makerspacewi/Lasercutter/doc/Schaltpläne_gr_LasercutterV8.pdf

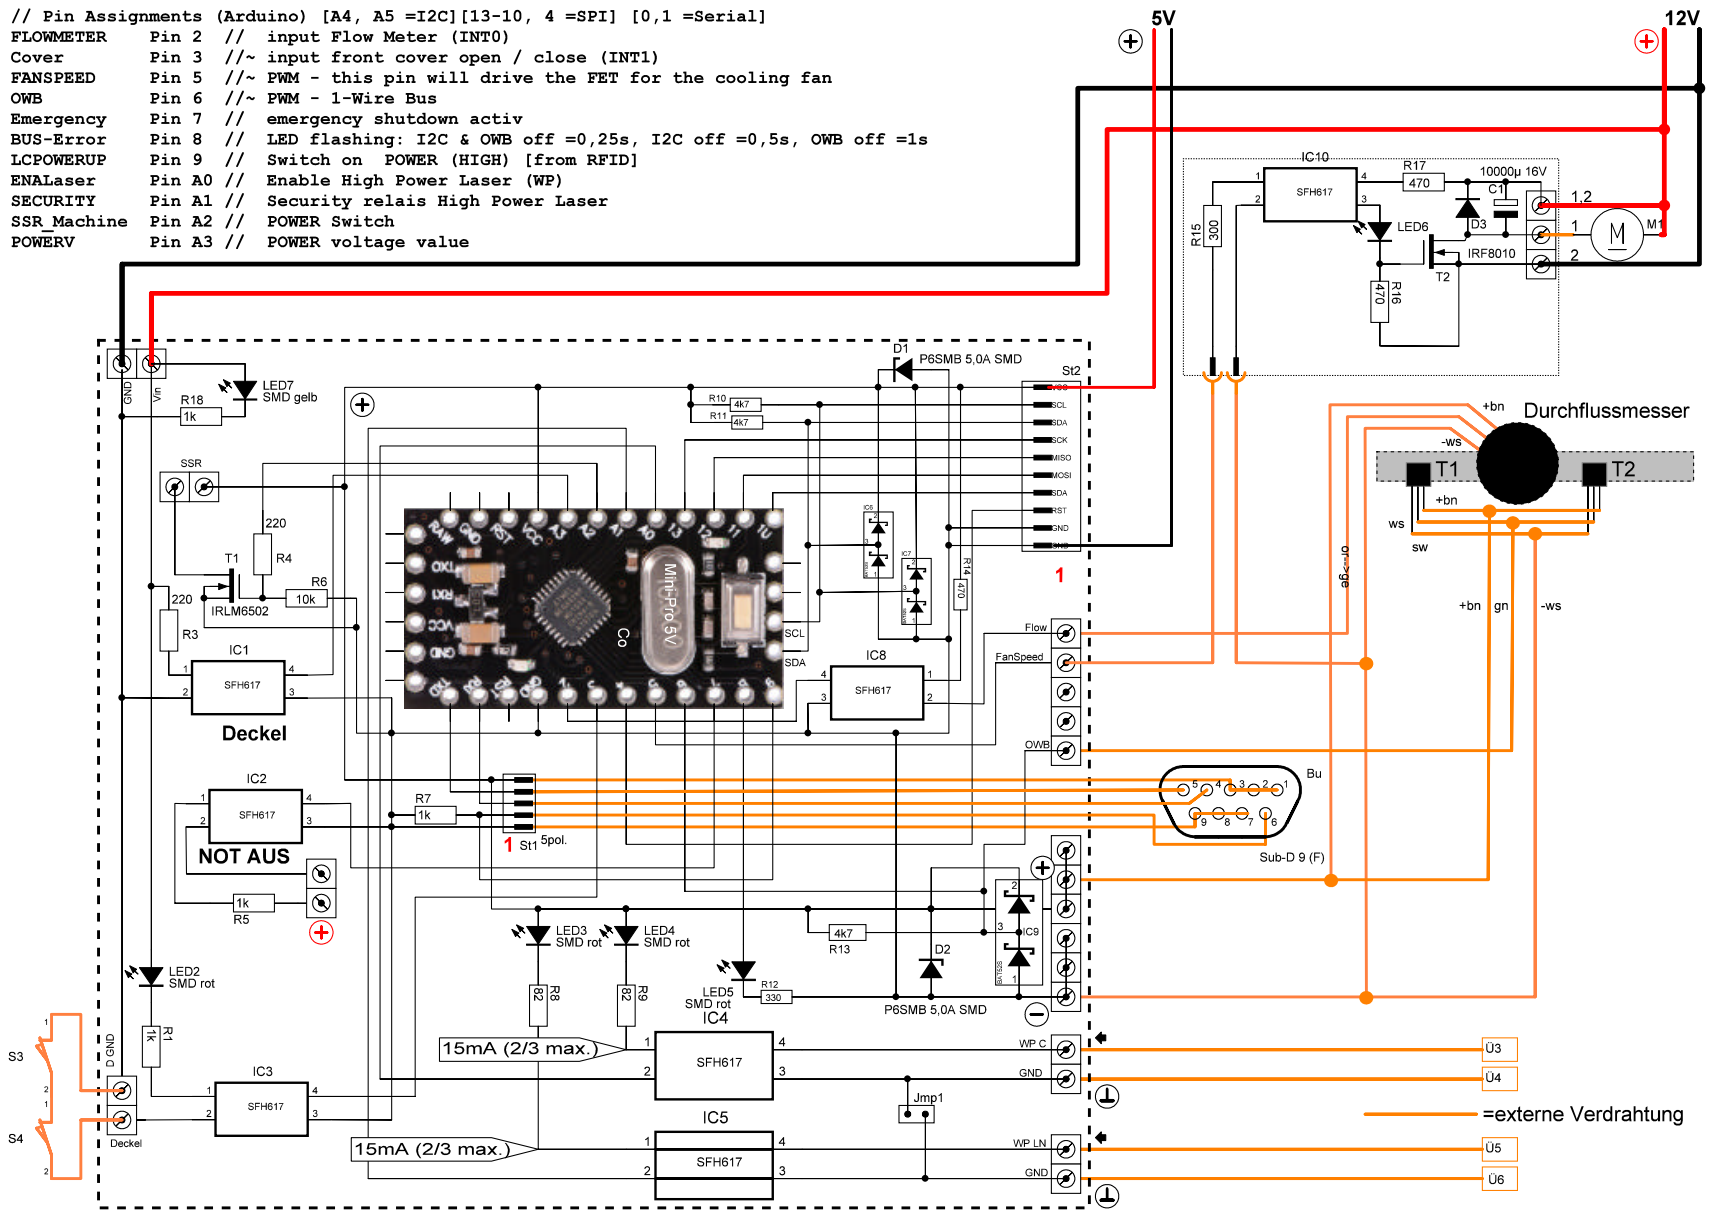
[picture p3: page 1]

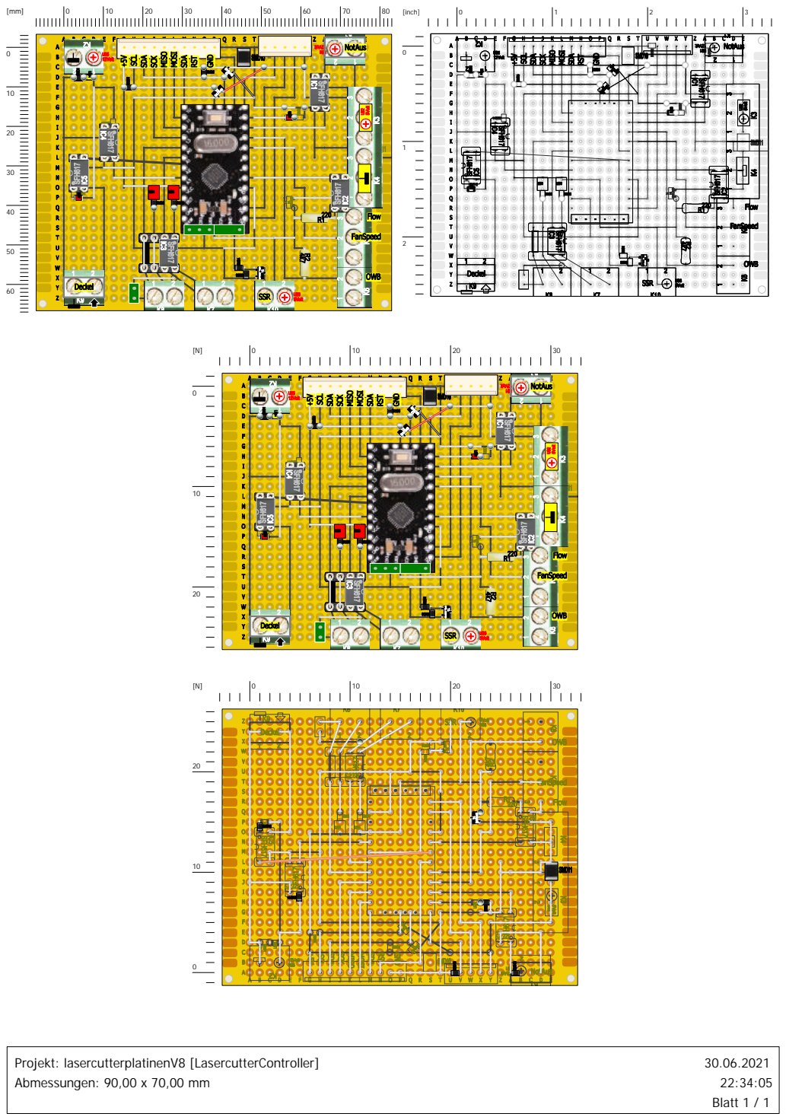
[picture p4: page 2]
[inch]; Projekt: lasercutterplatinenV8 [LasercutterController] Abmessungen: 90,00 x 70,00 mm; 30.06.2021 22:34:05 Blatt 1 / 1

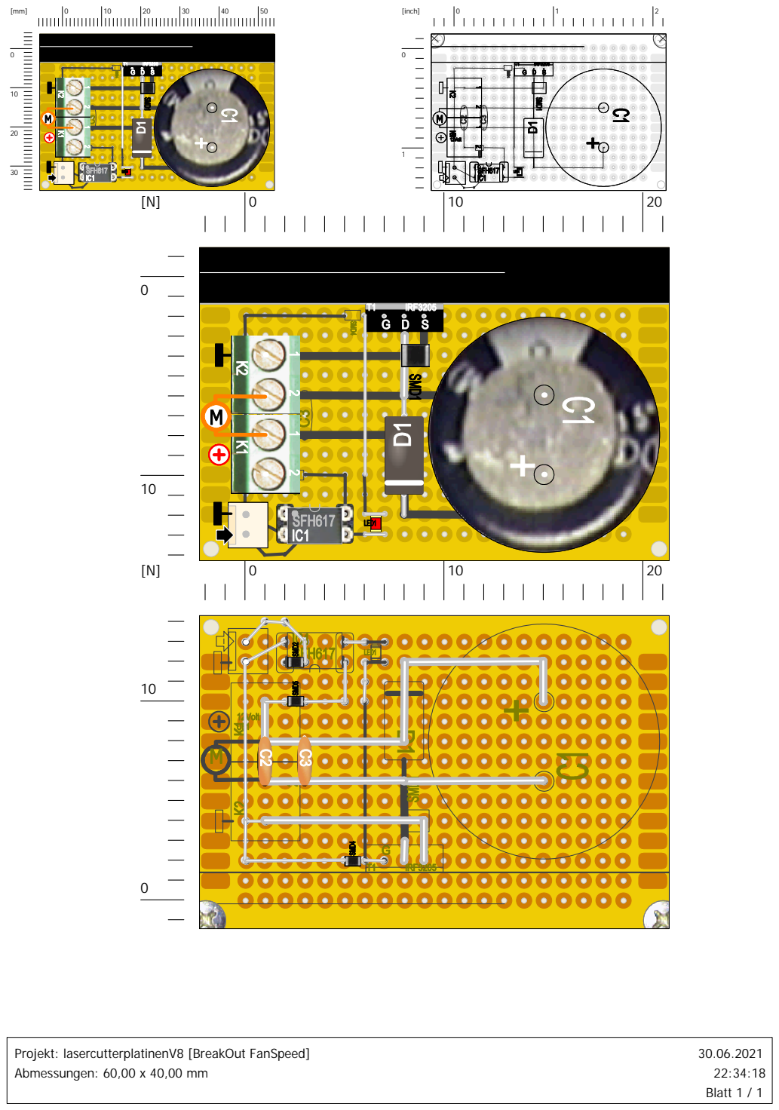
[picture p5: page 3]
[inch]

Projekt: lasercutterplatinenV8 [BreakOut FanSpeed]
Abmessungen: 60,00 x 40,00 mm

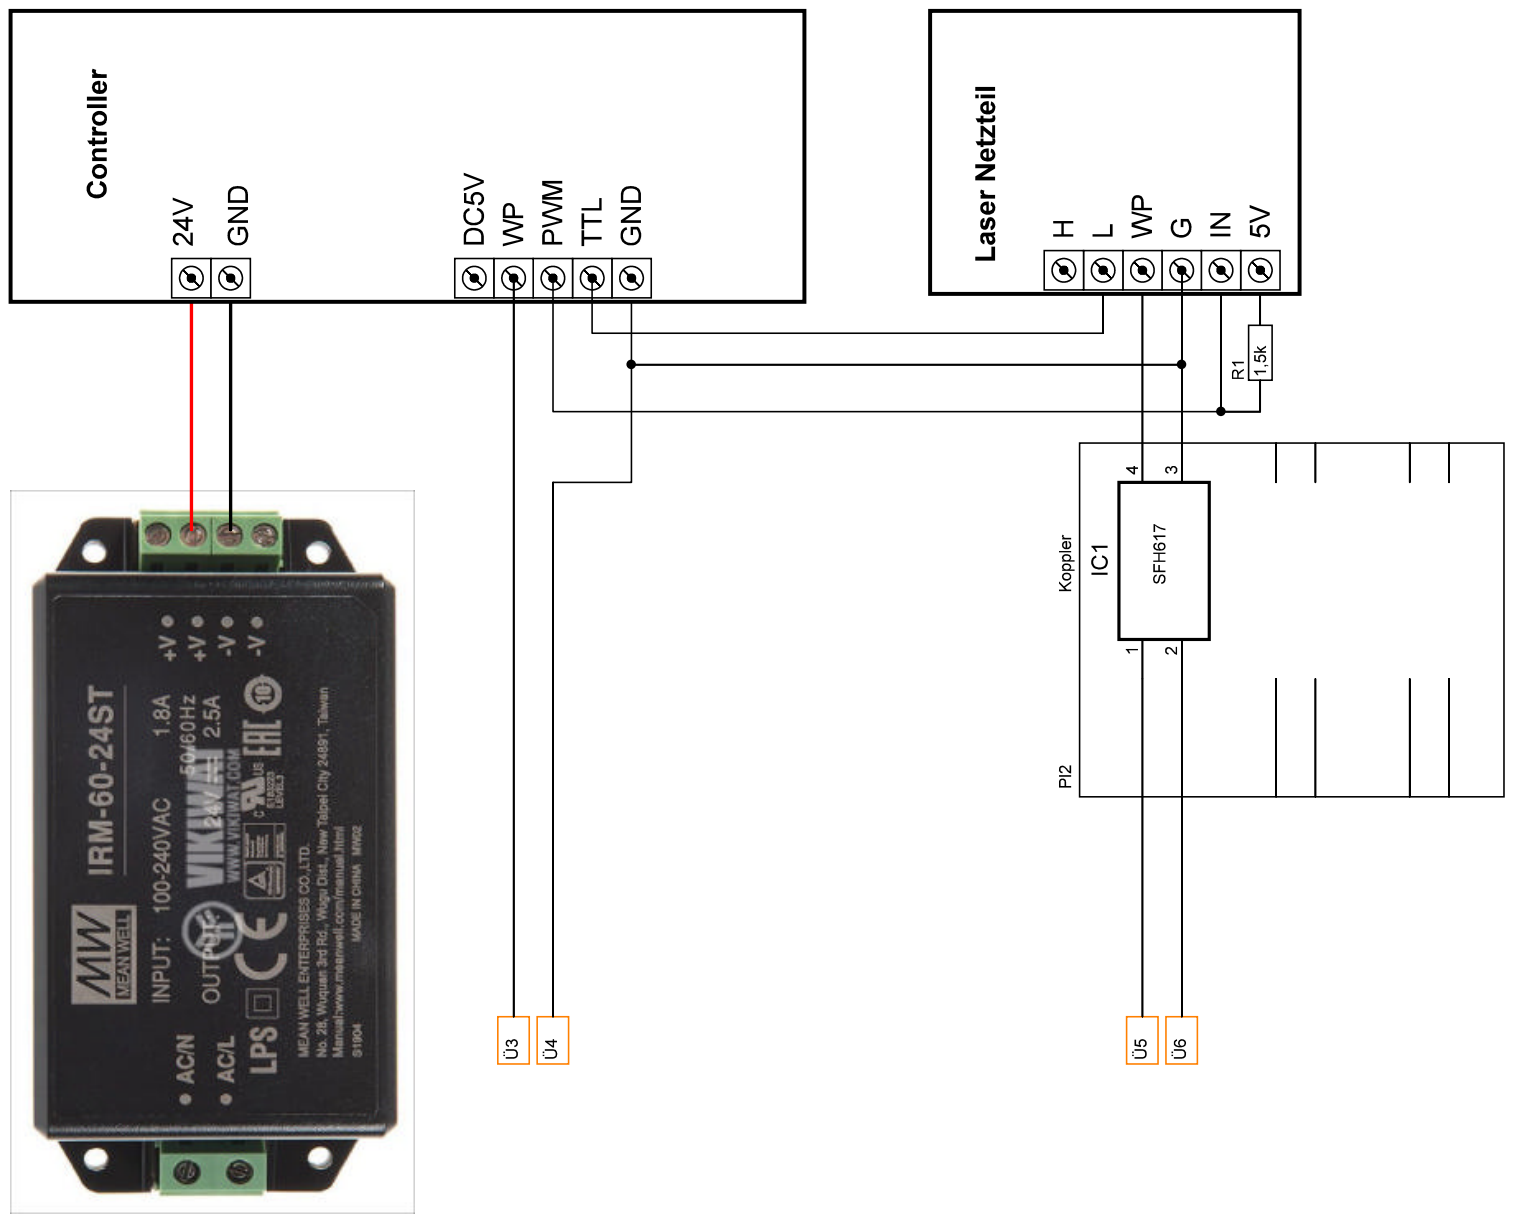
[picture p6: page 4]

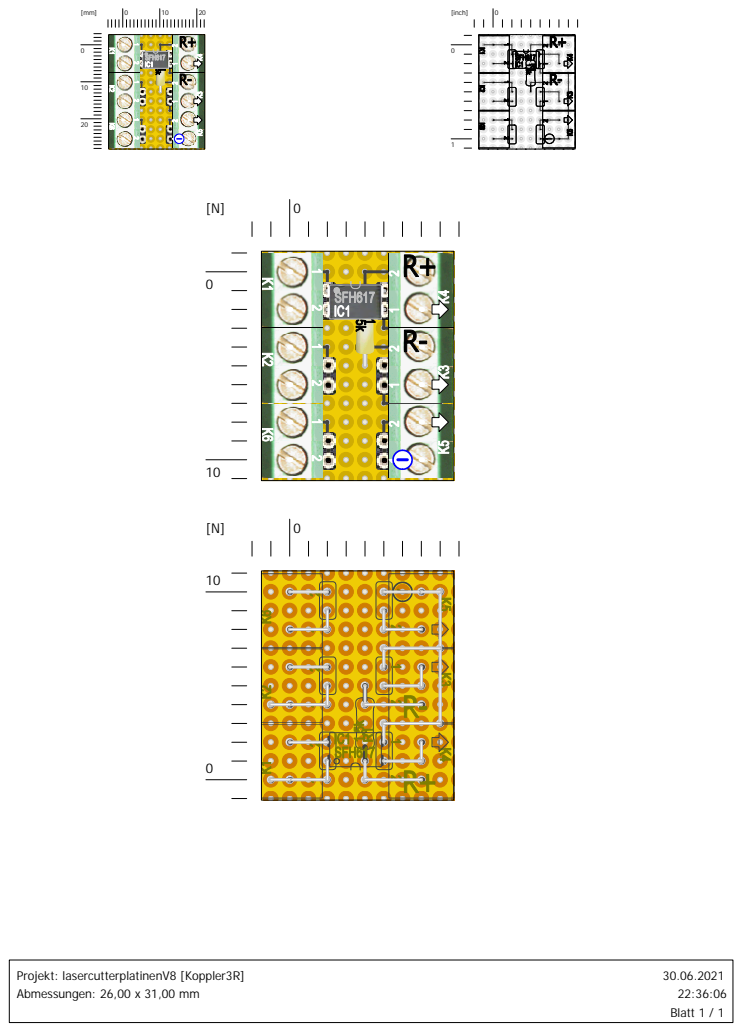
[picture p7: page 5]
[inch]; Projekt: lasercutterplatinenV8 [Koppler3R] Abmessungen: 26,00 x 31,00 mm

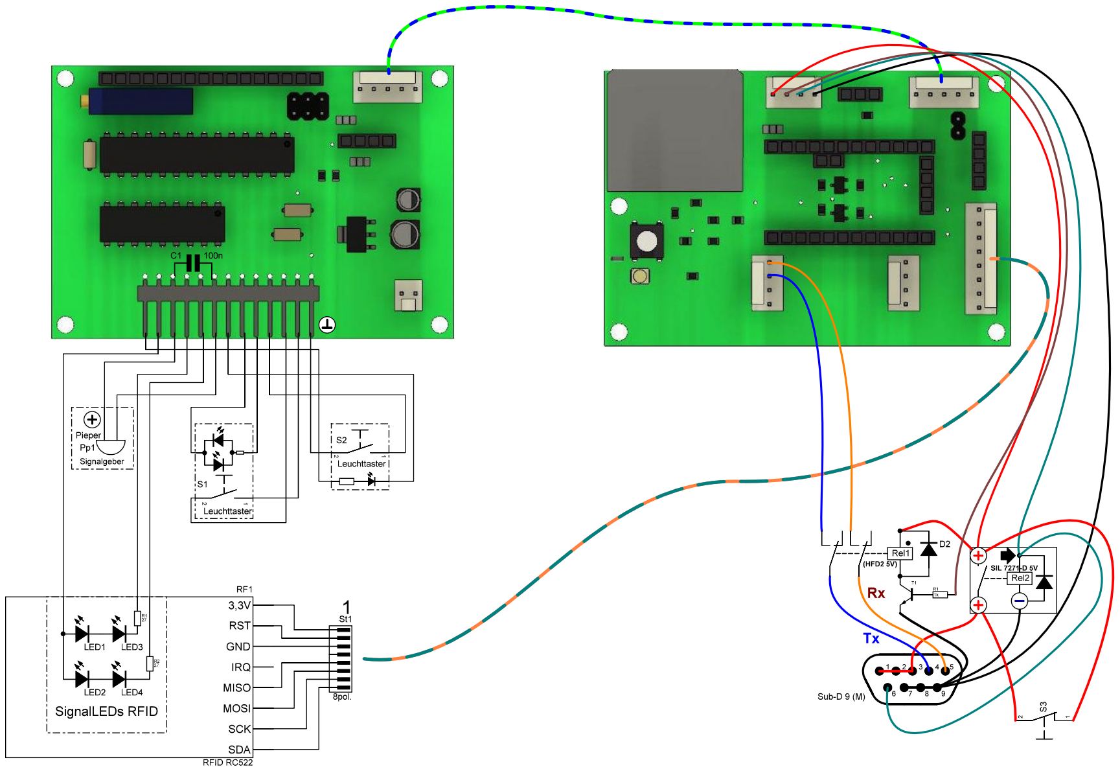
[picture p8: page 6]

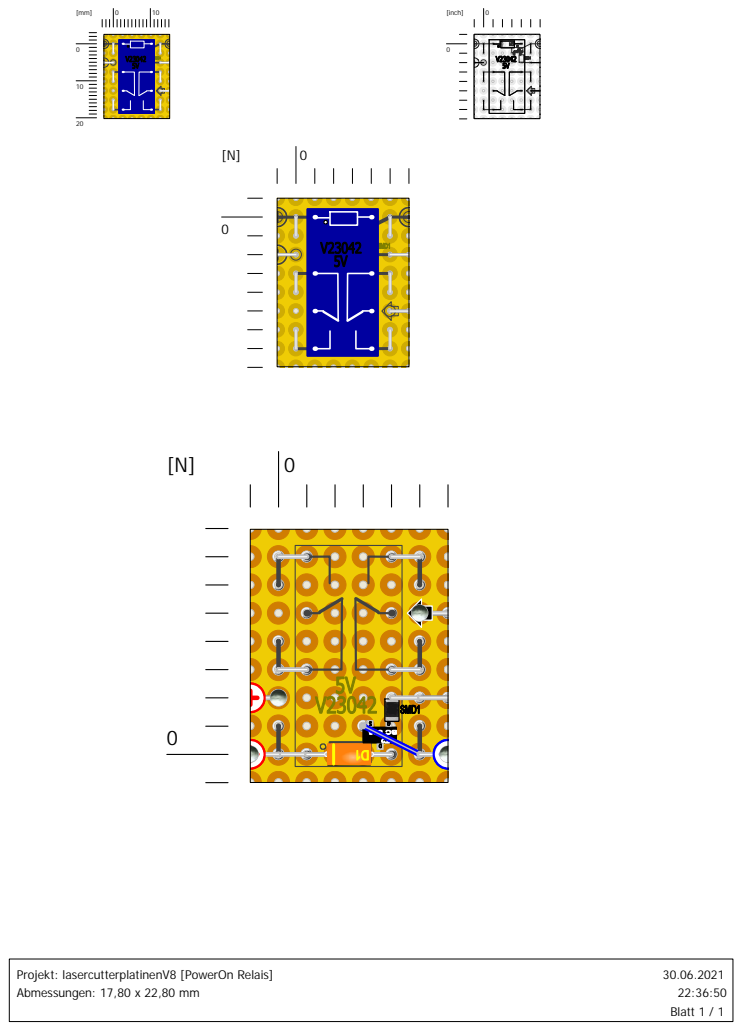
[picture p9: page 7]
[inch]

Projekt: lasercutterplatinenV8 [PowerOn Relais]
Abmessungen: 17,80 x 22,80 mm

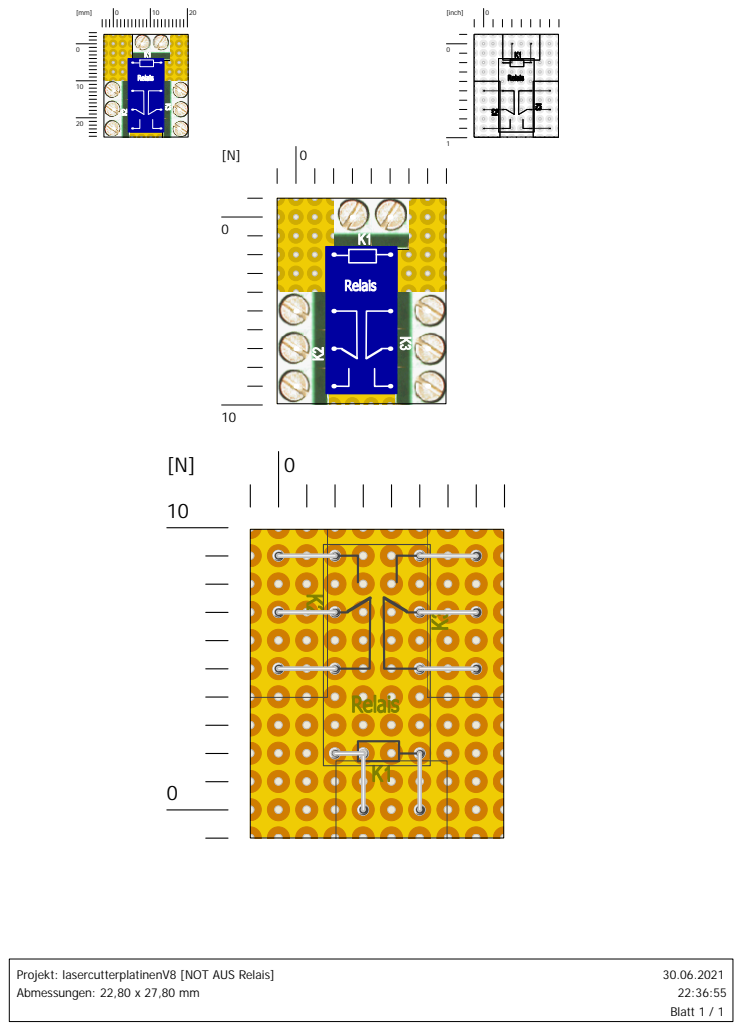
[picture p10: page 8]
[inch]

Projekt: lasercutterplatinenV8 [NOT AUS Relais]
Abmessungen: 22,80 x 27,80 mm

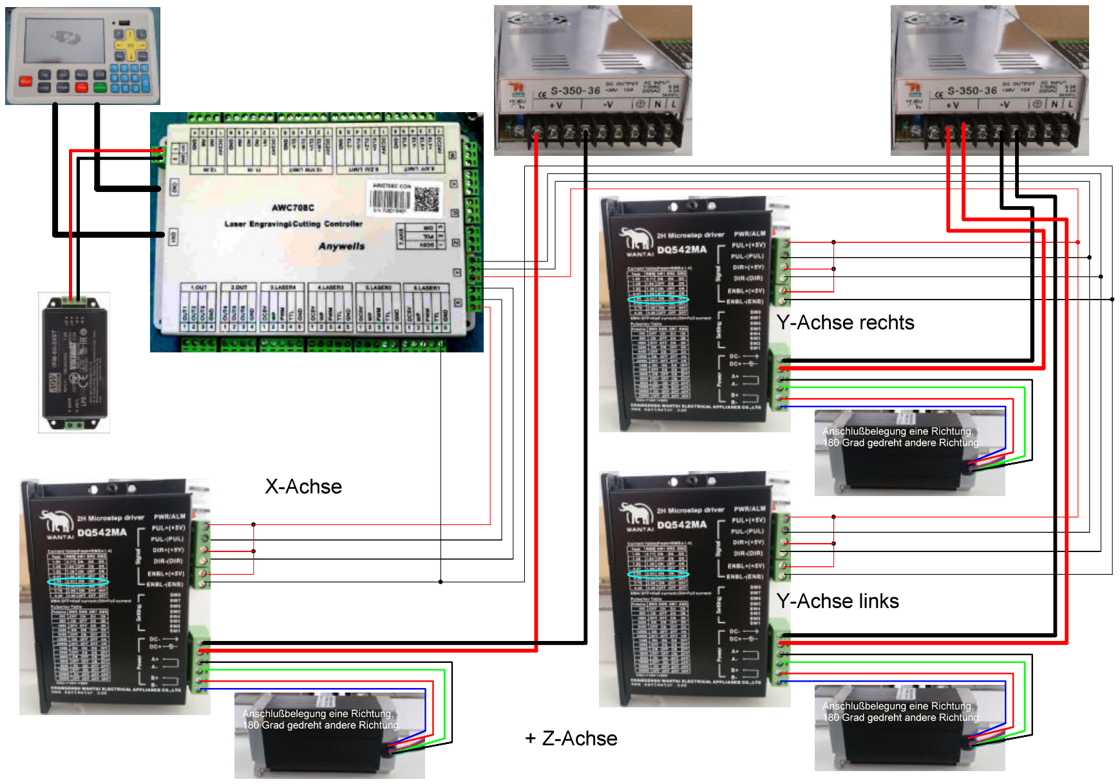
[picture p11: page 9]

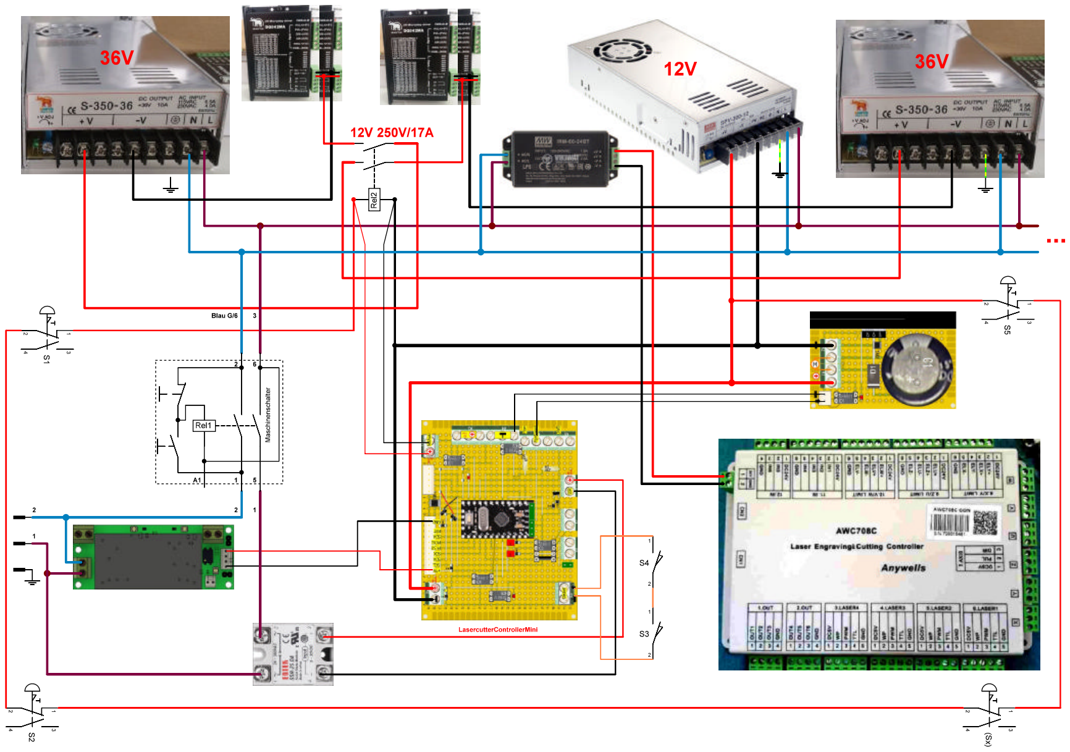
[picture p12: page 10]

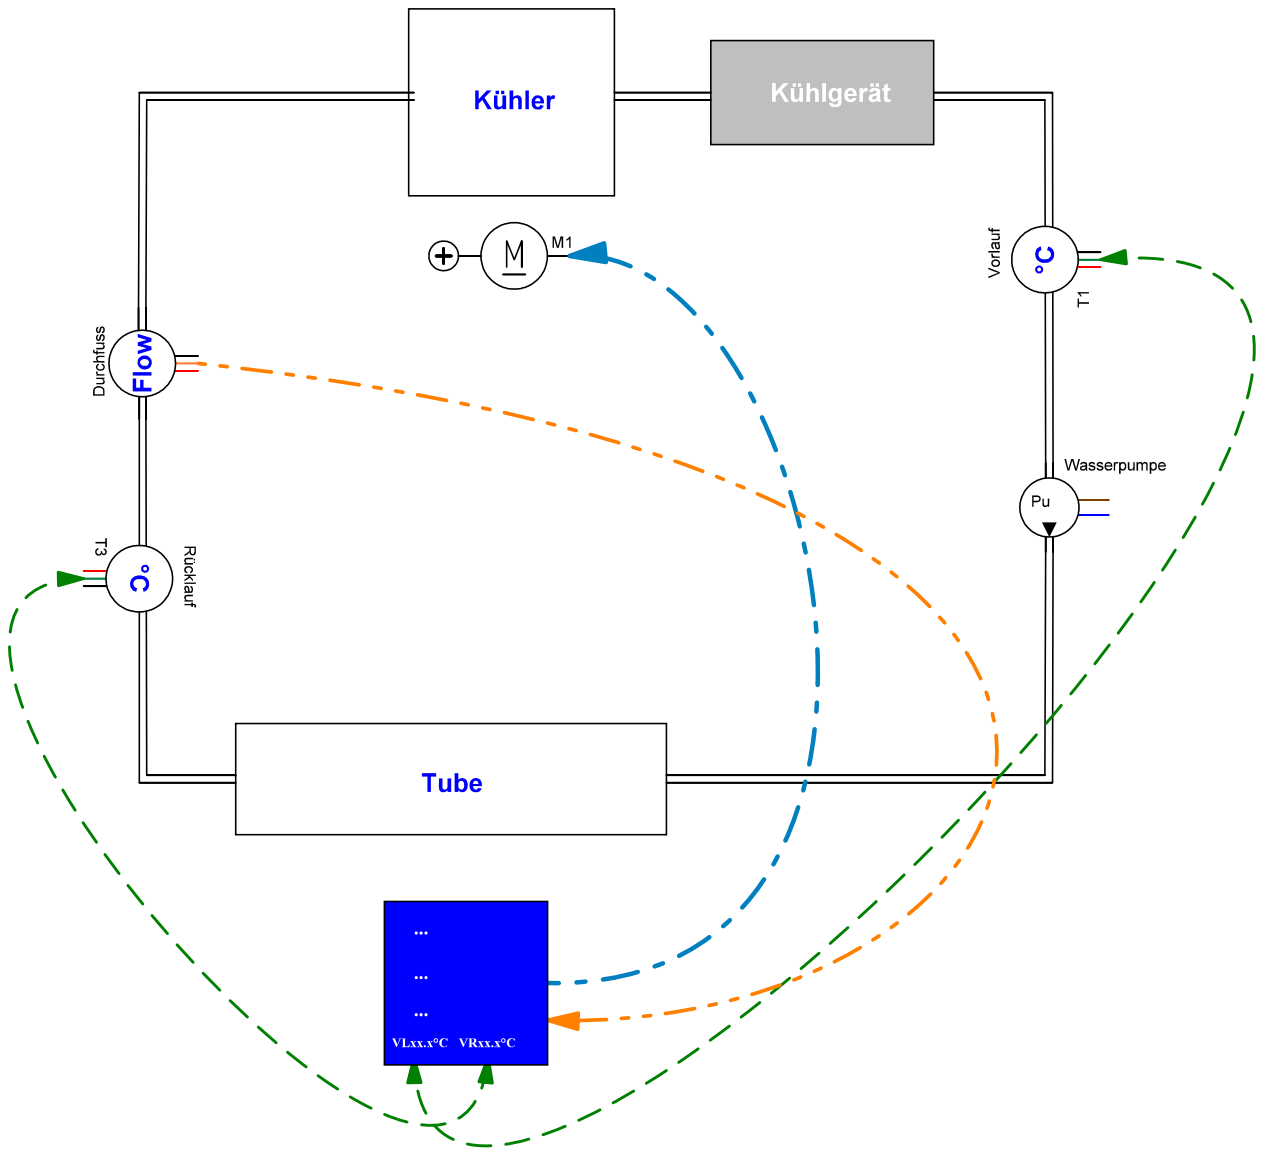
[picture p13: page 11]
