makerspacewi/Lasercutter/doc/Schaltpläne_gr_LasercutterV7.pdf

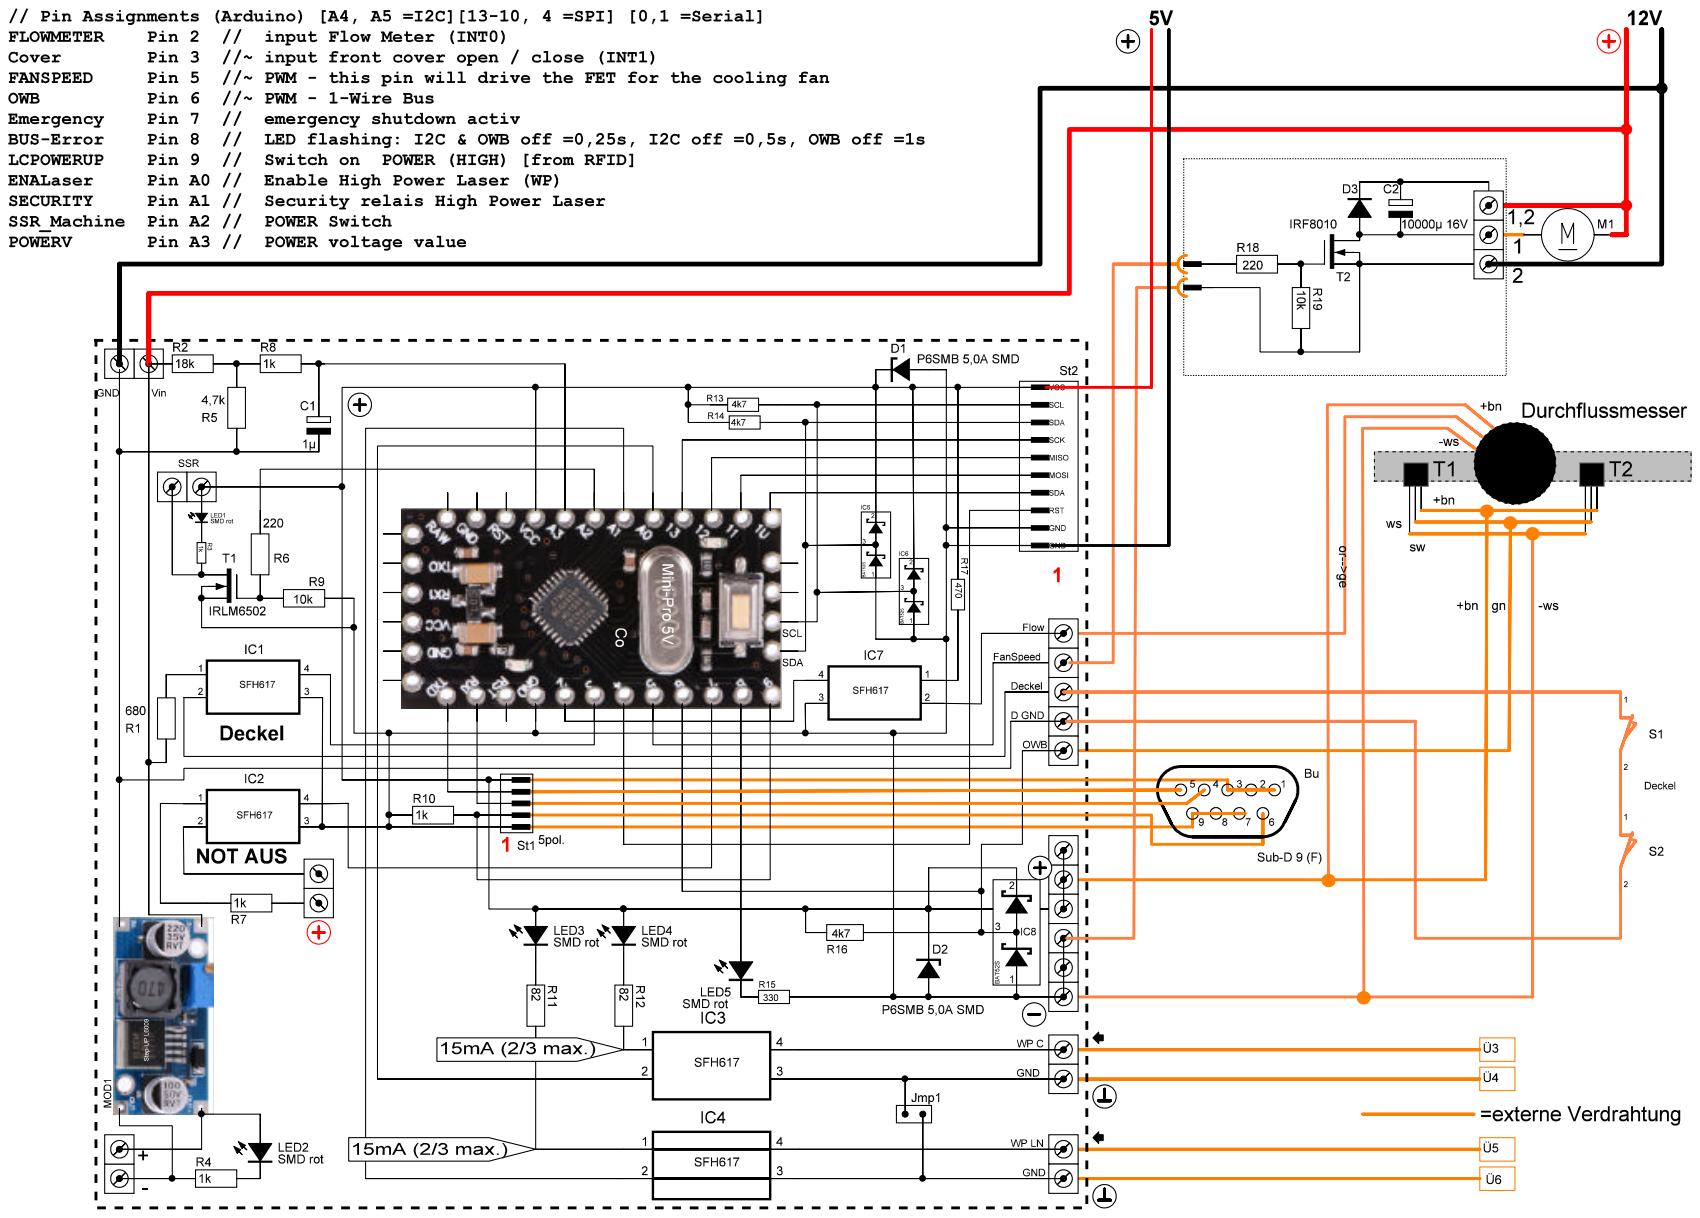
[picture p14: page 1]

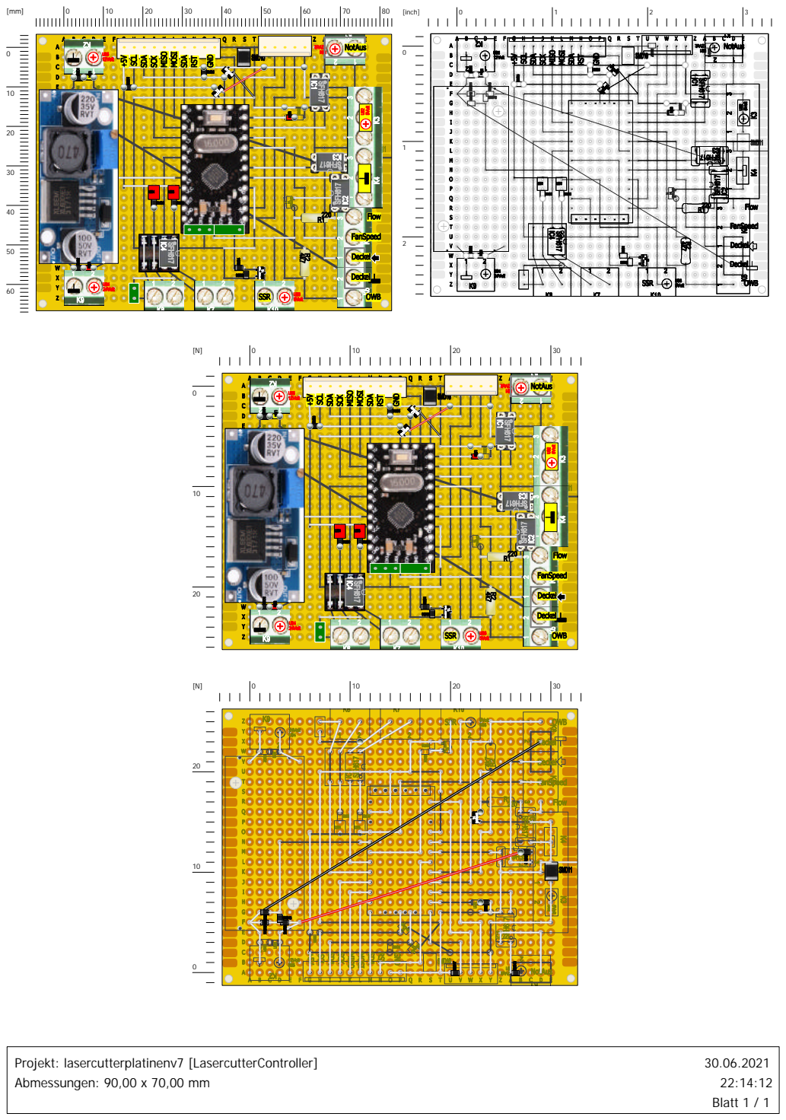
[picture p15: page 2]
[inch]; Projekt: lasercutterplatinenv7 [LasercutterController] Abmessungen: 90,00 x 70,00 mm; 30.06.2021 22:14:12 Blatt 1 / 1

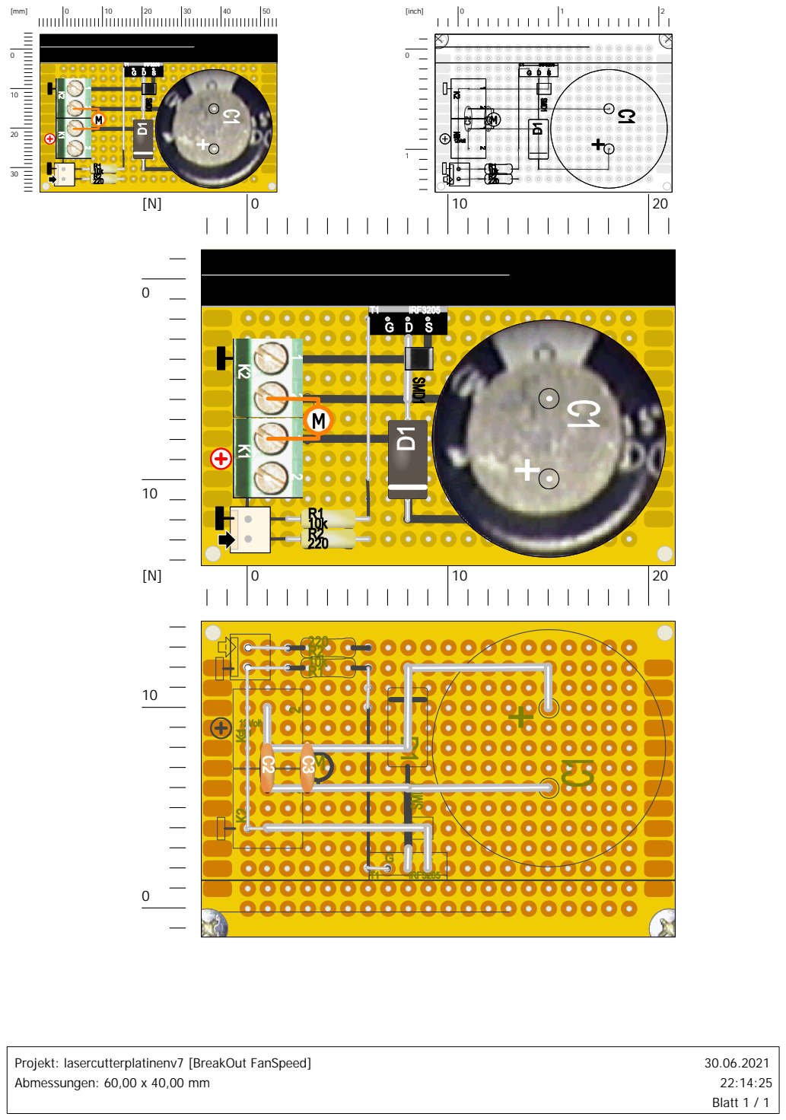
[picture p16: page 3]
[inch]

Projekt: lasercutterplatinenv7 [BreakOut FanSpeed]
Abmessungen: 60,00 x 40,00 mm


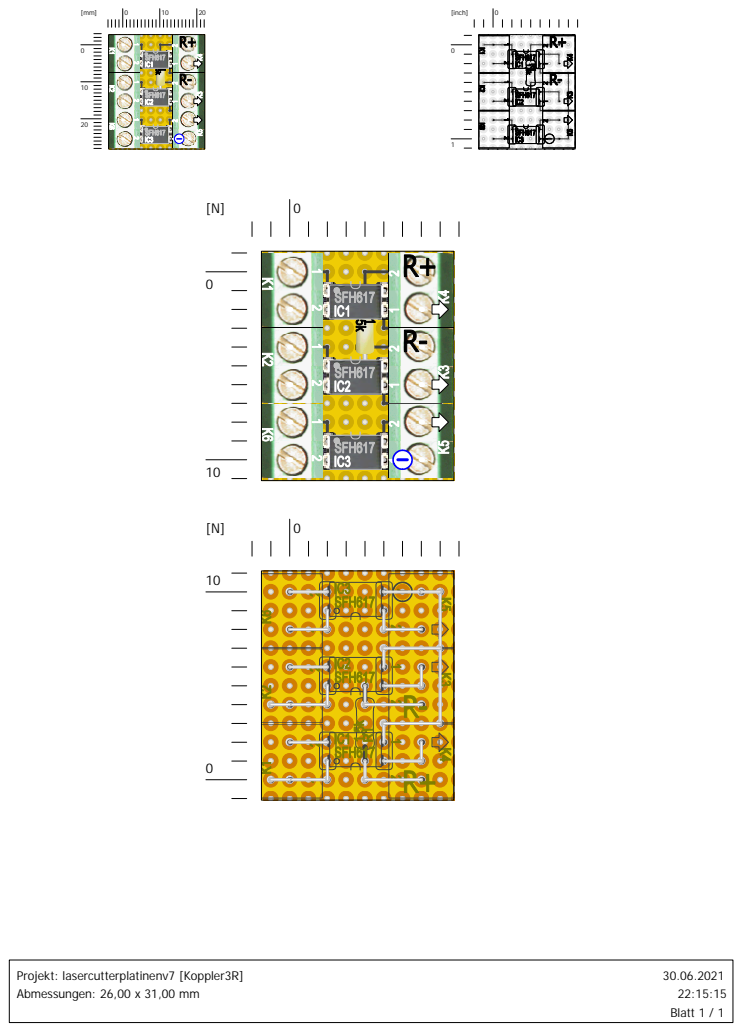
[picture p17: page 5]
[inch]; Projekt: lasercutterplatinenv7 [Koppler3R] Abmessungen: 26,00 x 31,00 mm

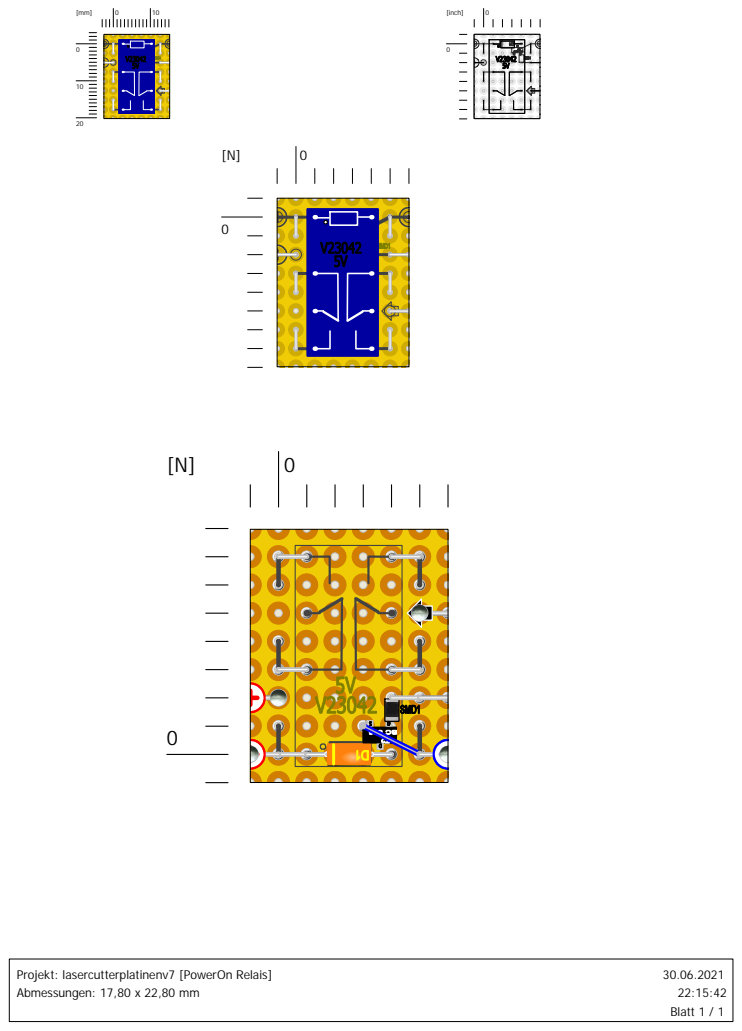
[picture p18: page 6]
[inch]

Projekt: lasercutterplatinenv7 [PowerOn Relais]
Abmessungen: 17,80 x 22,80 mm

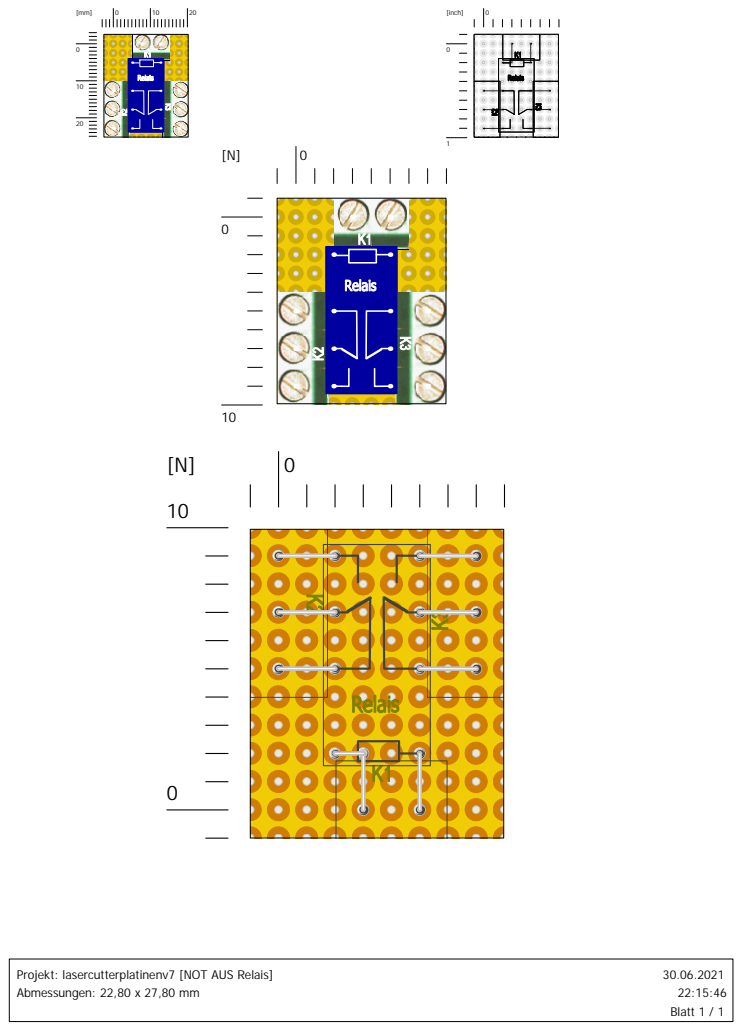
[picture p19: page 7]
[inch]

Projekt: lasercutterplatinenv7 [NOT AUS Relais]
Abmessungen: 22,80 x 27,80 mm


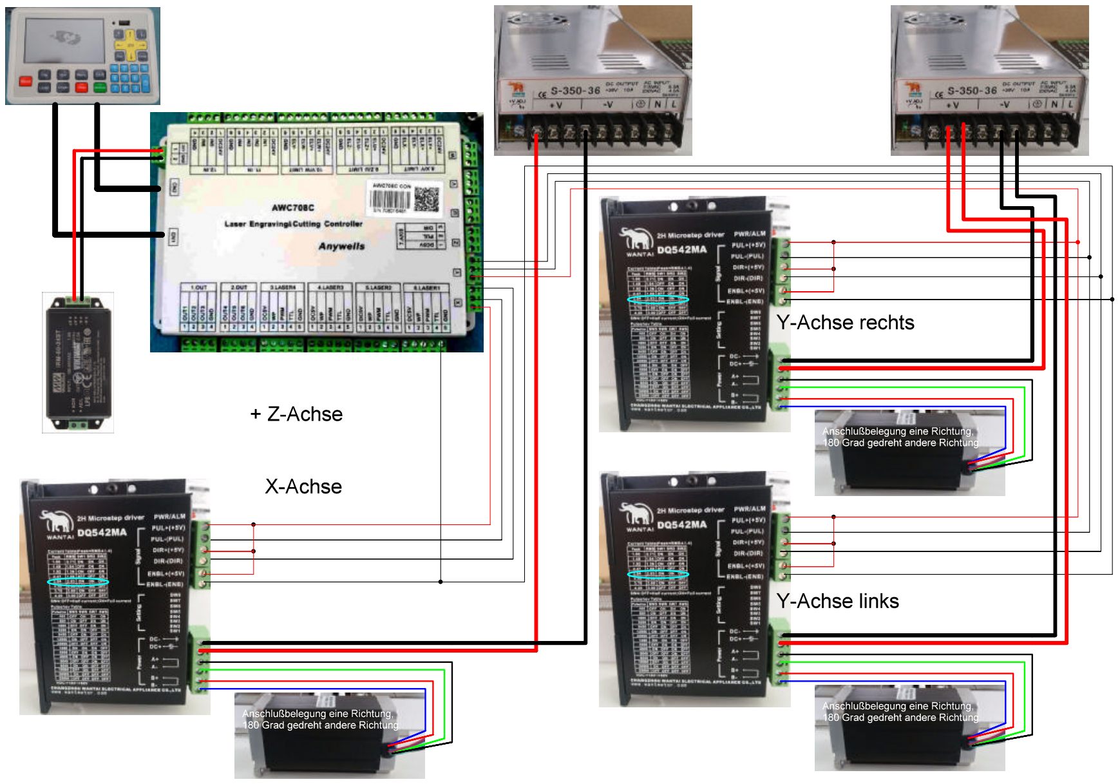
[picture p20: page 9]

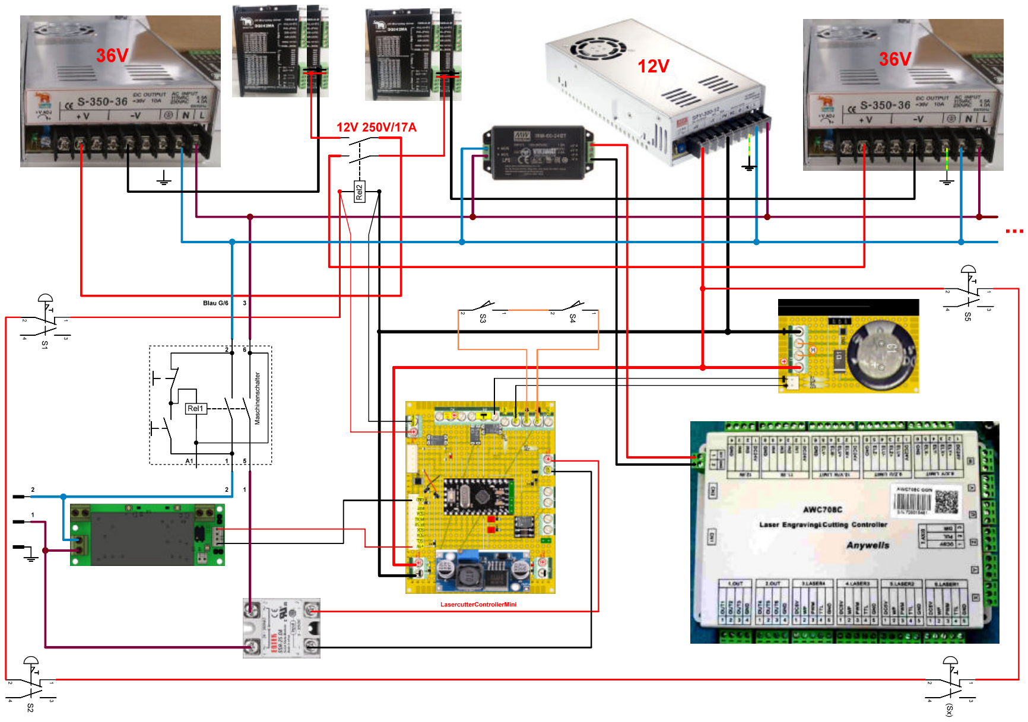
[picture p21: page 10]
