makerspacewi/Lasercutter/(commit log)

2020-10-24 Dieter - actual schematics update
2020-10-24 makerspace-wi / Lasercutter-gross-150W
2020-11-17 Changed from V6 to V7, without servo ...
2020-11-17 Modifiziere und ergaenzte Schaltbilder
2020-11-19 Send power on message first!
2021-07-01 Update documentation for extra 24V power supply
